kripanshukumar/BIKE-BELL-USING-ACCELLEROMETER/Bike_Bell_v3_Piezo/Schematic/Schematic_Bike Bell Piezo Electric_2021-05-18.pdf

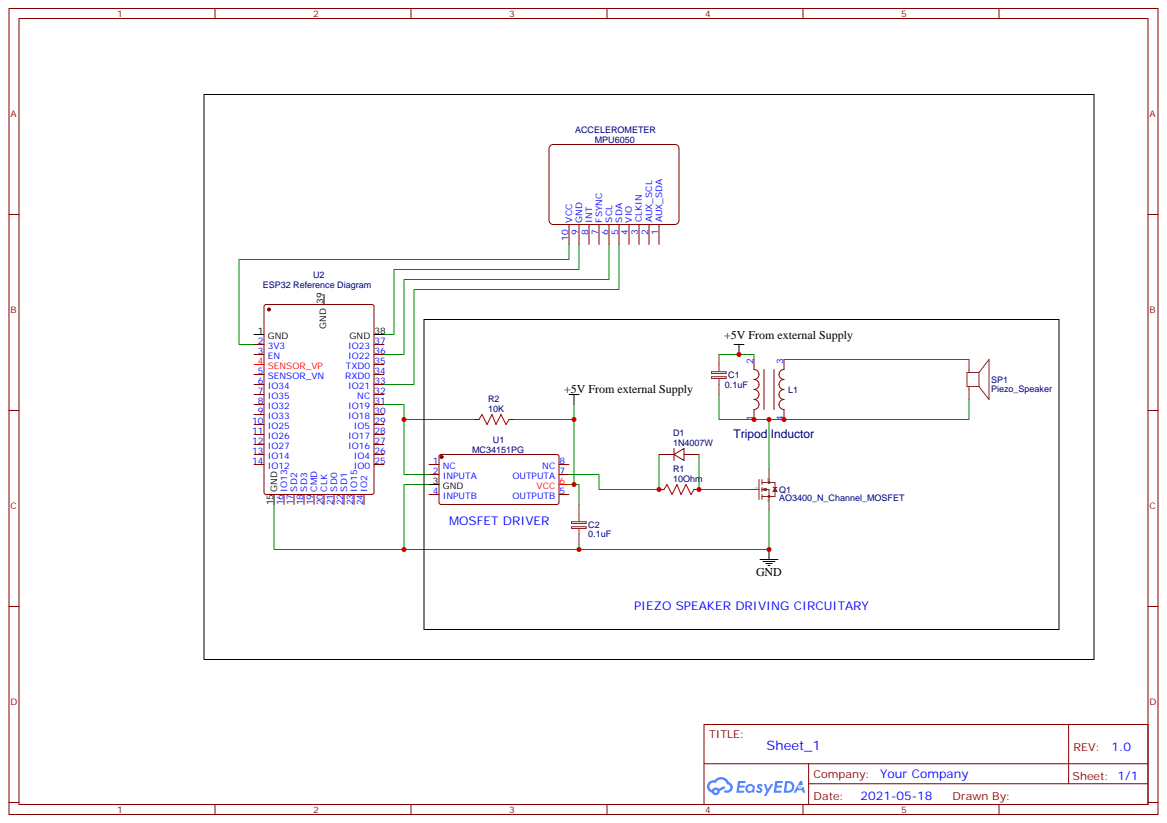
[picture p12: page 1]

IO0 25 IO² 24 IO¹⁵ 23 SD¹ 22 SD⁰ 21 CLK 20 CMD 19 SD³ 18 SD² 17 IO¹³ 16 GND 15

PIEZO SPEAKER DRIVING CIRCUITARY
